zachtey/bmi_chip_digital/ml/test_vectors.txt

// RTL TEST VECTORS — SBP+MLP 8->8->4
// Pipeline: ADC(8ch,250) -> SBP=sum(|x-128|)/250 -> MLP
// hidden_bias_scale = 85
// output_bias_scale = 109

// Vec 00: true=PG-LF  pred=SG-HF
// Expected CLASS[1:0] = 11 = 3
// Scores: [86146, -310628, -329147, 104393]
// SBP: [40, 27, 45, 39, 35, 34, 35, 31]
// ch0: 82 B4 B3 CC C0 7F 00 48 6F 77 FF E5 C4 B9 BA 7F 16 A6 EB 9F 9C 0A 22 78 F4 D0 AE C5 D8 99 85 6D 7C 65 5F B5 98 68 C6 BE 8A 9B B0 BD 6A C3 66 72 4B BF A9 77 8C E3 A1 A8 6F CE 71 9A AB 00 BA C7 B3 91 AA C4 9D 99 6E 79 91 86 84 9A AA E1 AC 6F 8D 2F 59 D6 B4 B0 AC A0 9F 90 8A 9D 89 A8 61 63 56 C6 D0 52 E6 B8 D5 A5 BF 3B 4C 4E A9 51 B5 95 CA C9 C7 A4 67 9F 6D 7C B1 99 BF 81 61 7C 9B 99 A9 AE 40 E4 AE C0 00 A8 EF C3 67 AC 69 A2 2D A5 A3 B5 9E AC 8C A7 83 9F 8F 8B 79 AD A5 9F 74 89 A7 A5 78 9C 9B 90 6E 8E 98 C3 BE CD 67 AA 61 83 7D 8B 23 FF B9 B6 7D A5 A1 7A 9C B4 5A 79 E3 75 72 7C AB AB A9 B9 93 6E 72 B8 A9 AA 58 BB 8B 65 60 C0 B5 AD A7 82 AE 7F 87 95 7C 9F 9F AA 7C A4 A8 7C 90 92 9C BF 59 85 9C A0 92 9F A5 A9 AC 57 77 99 93 E0 C7 62 59 C0 91 8D
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
