zachtey/bmi_chip_digital/(commit log)

2026-05-31 Fix async reset pattern for synthesis compatibility
    [mlp_inference.sv, sample_collection.sv, sbp_feature_extractor.sv]
2026-08-26 top level testbench comments; bug edit
    [tb_bmi_chip_top.sv]
2026-08-26 test: make SPI framing checks contribute to regression verdict
2026-08-26 Testbench checks for intermediate values for SBP and errors on mistakes
    [tb_bmi_chip_top.sv]
2026-09-01 spi tb added; verified
2026-09-01 MLP inference testbench added, scan-chain tb added, top level pipline added
2026-09-01 Delete coverage model and related sections from vPlan
    Removed sections on coverage models, regression suites, pass/fail policy, sign-off criteria, current baseline, and maintenance rules.
